elegantmonark/hardware-qrng/figures/README.md

# Figures

Figures are stored under the demonstrator whose data generated them. The current figures under `ED-1/` were produced from the preserved April 2026 dataset and must not be described as ED-2 results.

[MATLAB diagnostics](ED-1/matlab_diagnostics.png) show the same Arduino capture
analysed in MATLAB R2026b Update 1. The [saved results](../results/ED-1/matlab/README.md)
include the editable figure and numerical output.
