elegantmonark/hardware-qrng/hardware/ED-1/README.md

# ED-1 hardware

ED-1 is the original working demonstrator. It established the acquisition and analysis pipeline and produced the preserved April 2026 dataset.

Its photographs are historical evidence of that build. They must not be presented as photographs of ED-2, whose analogue path and status indicator differ.

## Photographs

### Breadboard overview

ED-1 breadboard overview

Top view of the first breadboard demonstrator, including its wired indicators and buzzer.

### Close view of the analogue stage

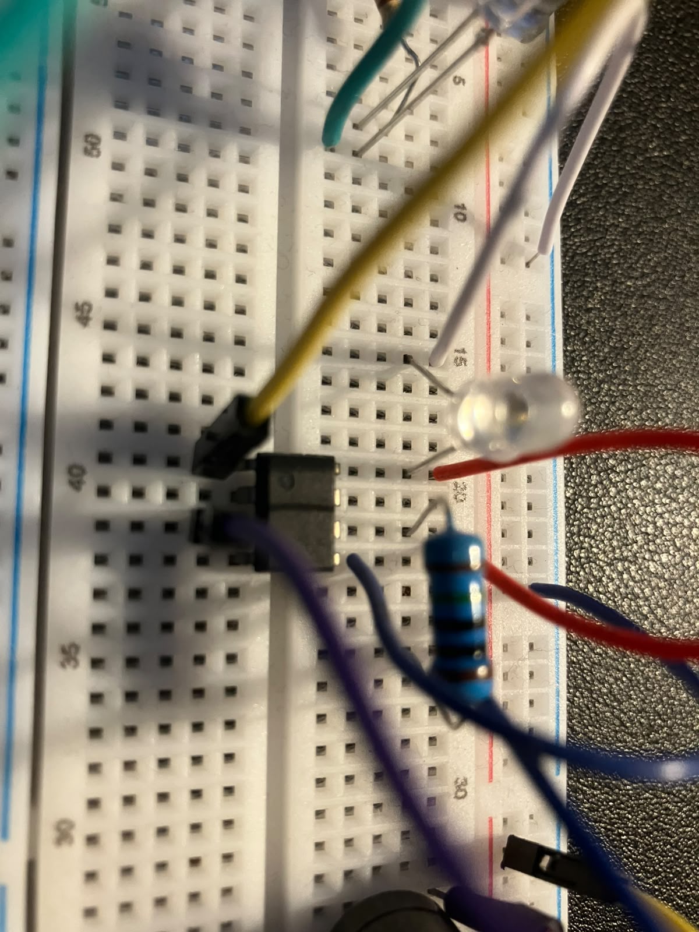
[picture p17: hardware/ED-1/photos/ed1-analogue-stage-closeup.jpeg]
ED-1 analogue-stage close-up


Close view of the original LM358 area, source LED and nearby connections.
