elegantmonark/hardware-qrng/data/ED-3/README.md

# ED-3 data

This directory is reserved for ED-3 control and source captures. No dataset
should be retained here until the staged circuit checks have passed and the
exact hardware configuration has been photographed and recorded.
