elegantmonark/hardware-qrng/hardware/ED-2/photos/README.md

# ED-2 photographs

- `ed2-breadboard-overview.jpeg`: top view of the complete ED-2 breadboard.
- `ed2-analogue-stage-closeup.jpeg`: close view of the circuit from a lower angle, with the Arduino in the background.
- `ed2-current-breadboard-closeup.jpeg`: clearest view of the latest documented ED-2 breadboard arrangement, photographed on 18 October 2026.
- `ed2-current-system-overview.jpeg`: wider view of that arrangement with the Arduino connection visible, photographed on 18 October 2026.

The source files contain no embedded location metadata. The photographs document hardware configuration only and do not establish electrical or statistical validation.
