elegantmonark/hardware-qrng/hardware/ED-3/photos/README.md

# ED-3 photographs

Add photographs only after the simplified breadboard has been assembled and its
connections have been checked. Record the date, circuit revision and whether the
pictured configuration produced a retained dataset.
