elegantmonark/hardware-qrng/hardware/ED-4/photos/README.md

# ED-4 photographs

- `ed4-printed-enclosure.jpeg`: first printed enclosure base, showing the rails, locating features and cable opening on 18 October 2026.
- `ed4-perfboard-fit-check.jpeg`: unpopulated 89 by 52 mm perfboard seated in the printed base for the initial fit check on 18 October 2026.

These images demonstrate a successful initial mechanical fit. They do not show an assembled or electrically validated ED-4 circuit.
