elegantmonark/hardware-qrng/hardware/ED-1/photos/README.md

# ED-1 photographs

- `ed1-breadboard-overview.jpeg`: top view of the complete original breadboard.
- `ed1-analogue-stage-closeup.jpeg`: close view of the LM358 and LED region.

These photographs document ED-1 and are not images of the later ED-2 circuit.
