elegantmonark/hardware-qrng/figures/ED-1/entropy_plot.png

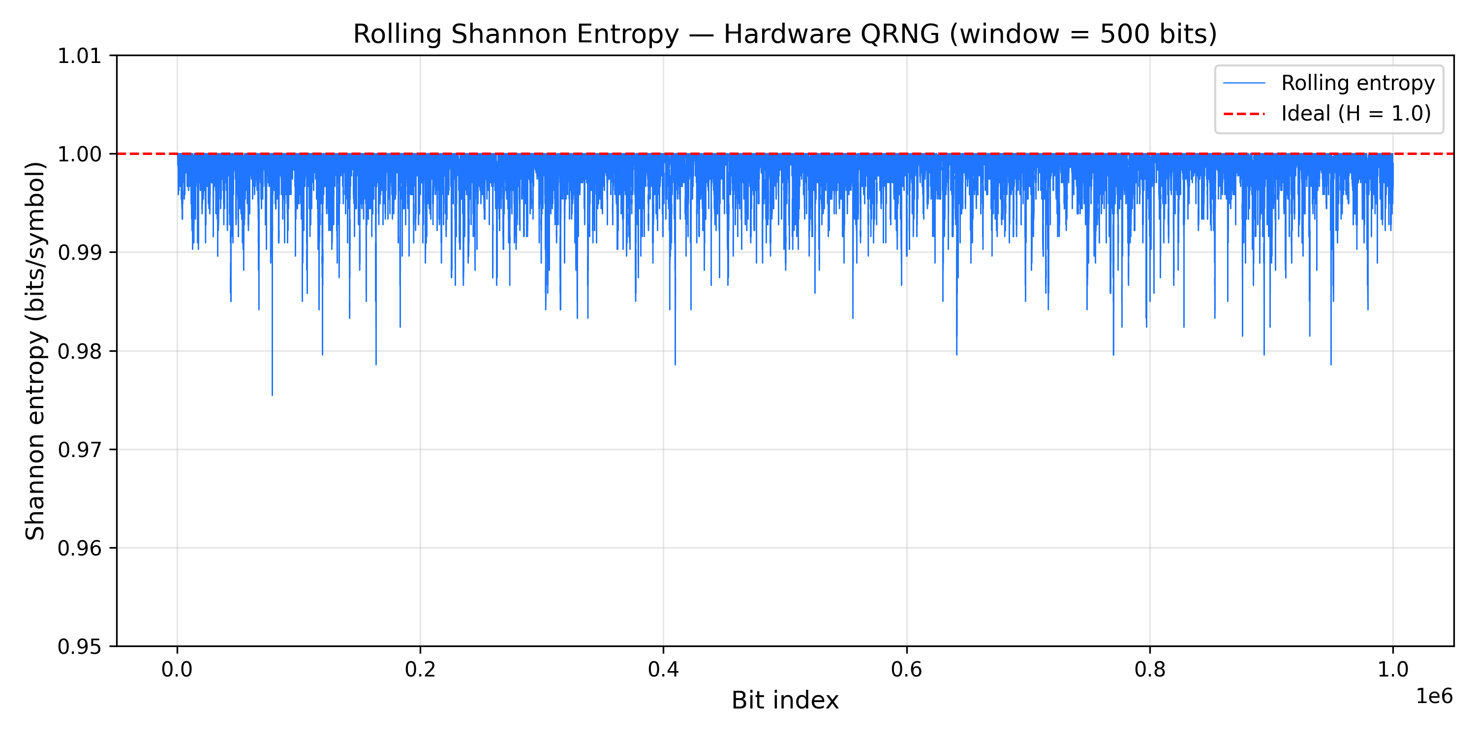
figures/ED-1/entropy_plot.png
