elegantmonark/hardware-qrng/hardware/ED-4/kicad/exports/ed4-perfboard-prototype-bottom.png

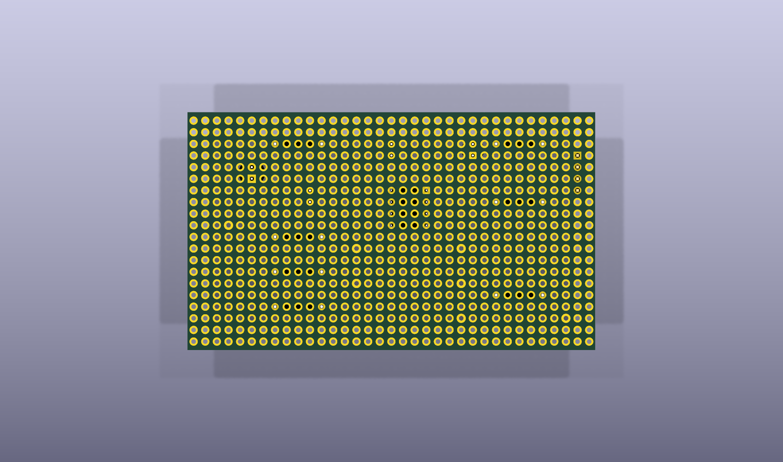
hardware/ED-4/kicad/exports/ed4-perfboard-prototype-bottom.png
