elegantmonark/hardware-qrng/hardware/ED-4/kicad/exports/ed4-perfboard-prototype-top.png

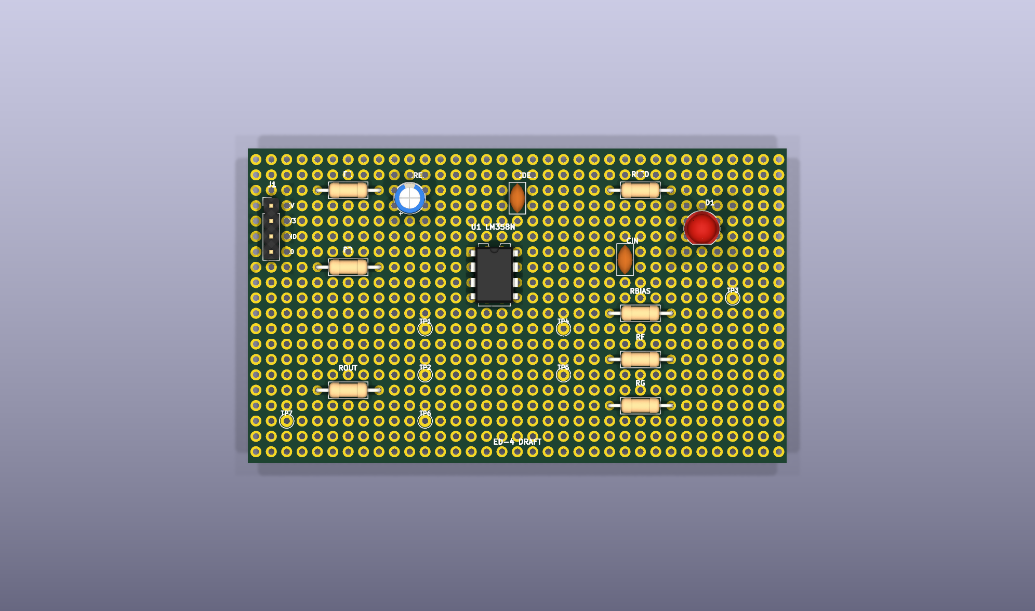
hardware/ED-4/kicad/exports/ed4-perfboard-prototype-top.png
