elegantmonark/hardware-qrng/hardware/ED-4/pcb/ED4-A/jlcpcb/ED4_A_RevB_JLCPCB_BOM.csv

Comment | Designator | Footprint | JLCPCB Part # | Manufacturer Part Number
ARDUINO | J1 | PinHeader_1x04_P2.54mm_Vertical | C7221145 | M20-9990446
MCP6002-I/P | U1 | DIP-8_W7.62mm | C640394 | MCP6002-I/P
10k | R1 | R_Axial_DIN0207_L6.3mm_D2.5mm_P10.16mm_Horizontal | C1519255 | MFR-25FBF52-10K
10k | R2 | R_Axial_DIN0207_L6.3mm_D2.5mm_P10.16mm_Horizontal | C1519255 | MFR-25FBF52-10K
10uF | C1 | CP_Radial_D5.0mm_P2.00mm | C106654 | ERS1HM100D11OT
100nF | C2 | C_Disc_D5.0mm_W2.5mm_P2.50mm | C524651 | RDER71H104K0S1H03A
10uF | C3 | CP_Radial_D5.0mm_P2.00mm | C106654 | ERS1HM100D11OT
SOURCE OR CONTROL | JP1 | PinHeader_1x03_P2.54mm_Vertical | C5355646 | M20-9990346
100nF | C4 | C_Rect_L7.2mm_W2.5mm_P5.00mm | C97687 | MKS2C031001A00KSSD
1k | R5 | R_Axial_DIN0207_L6.3mm_D2.5mm_P10.16mm_Horizontal | C1364484 | MFR-25FBF52-1K
1k | R7 | R_Axial_DIN0207_L6.3mm_D2.5mm_P10.16mm_Horizontal | C1364484 | MFR-25FBF52-1K
