elegantmonark/hardware-qrng/hardware/ED-3/cad/ed3_base.stl

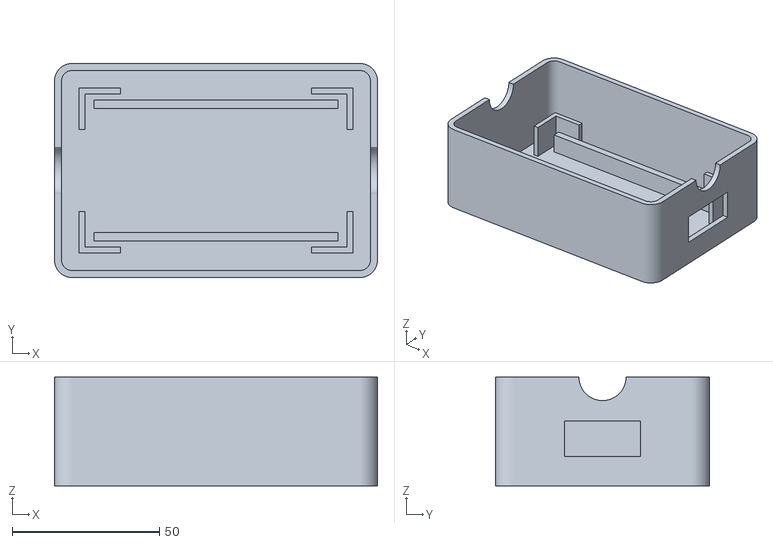
[picture p27: CAD file, 2026-10-16]
hardware/ED-3/cad/ed3_base.stl
109.8 x 72.8 x 37.0
