elegantmonark/hardware-qrng/hardware/ED-4/cad/ed4_lid.stl

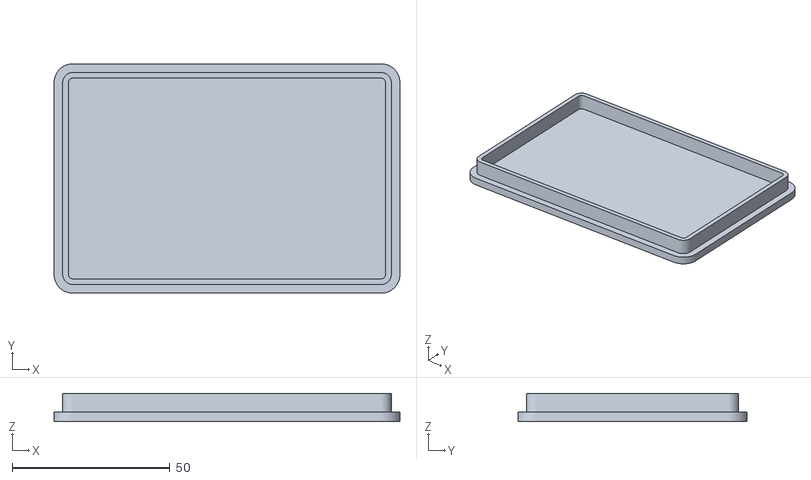
[picture p28: CAD file, 2026-10-17]
hardware/ED-4/cad/ed4_lid.stl
109.8 x 72.8 x 9.00
