elegantmonark/hardware-qrng/(list of files, cad)

Other CAD files:
hardware/ED-4/cad/ed4_enclosure.scad
