elegantmonark/hardware-qrng/results/README.md

# Results

Results are separated by demonstrator and dataset. `ED-1/` contains the April 2026 audit and exploratory NIST STS outputs. No ED-2 statistical result should be added without its source dataset, metadata, and exact analysis command.

[MATLAB results](ED-1/matlab/README.md) contain the exported report, summary,
correlations and editable figure from analysis of the original Arduino capture.
