elegantmonark/hardware-qrng/results/ED-1/nist/README.md

# ED-1 exploratory NIST STS results

These files record exploratory testing of the preserved April 2026 ED-1 bitstream. They are retained for transparency and are not evidence of certification or cryptographic suitability.
