elegantmonark/hardware-qrng/results/ED-1/matlab/autocorrelation.csv

lags | rawAcf | bitAcf
0 | 1 | 1
1 | 0.905703941458342 | 0.00119307981327386
2 | 0.648338970932204 | -0.000847972736750477
3 | 0.281083008862342 | -0.00116897203801129
4 | -0.127963543272865 | 5.00648950270875e-05
5 | -0.505038471001941 | 0.00186511913377597
6 | -0.785984445532592 | -0.000523949937571101
7 | -0.930931903308537 | 0.00107309255088027
8 | -0.920346089999902 | -0.00012394877930944
9 | -0.755725271255222 | 0.000183051030901383
10 | -0.459099145915034 | -0.000159959077419183
11 | -0.0736146732049842 | -0.00220903159773946
12 | 0.334114395782394 | 0.000462060433140151
13 | 0.690365283552068 | -0.000268963208252143
14 | 0.92862595560735 | 0.000992079308777697
15 | 0.998006396714877 | 0.00170510519747965
16 | 0.879731687416893 | 0.00202211827758914
17 | 0.604249335466105 | -0.00101898314121326
18 | 0.227248370902159 | 0.000938090080624857
19 | -0.181759074843972 | -4.94572756822201e-06
20 | -0.549227526489565 | 0.00105209647083485
21 | -0.813786206689639 | -0.000446963875666681
22 | -0.938701149457202 | -0.00118800435730024
23 | -0.906963148330584 | -0.00011495948363881
24 | -0.72306228483475 | 0.000122050796799136
25 | -0.41151233671605 | -0.000674975991193557
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
