elegantmonark/hardware-qrng/hardware/ED-4/kicad/exports/ed4-perfboard-prototype-schematic.pdf

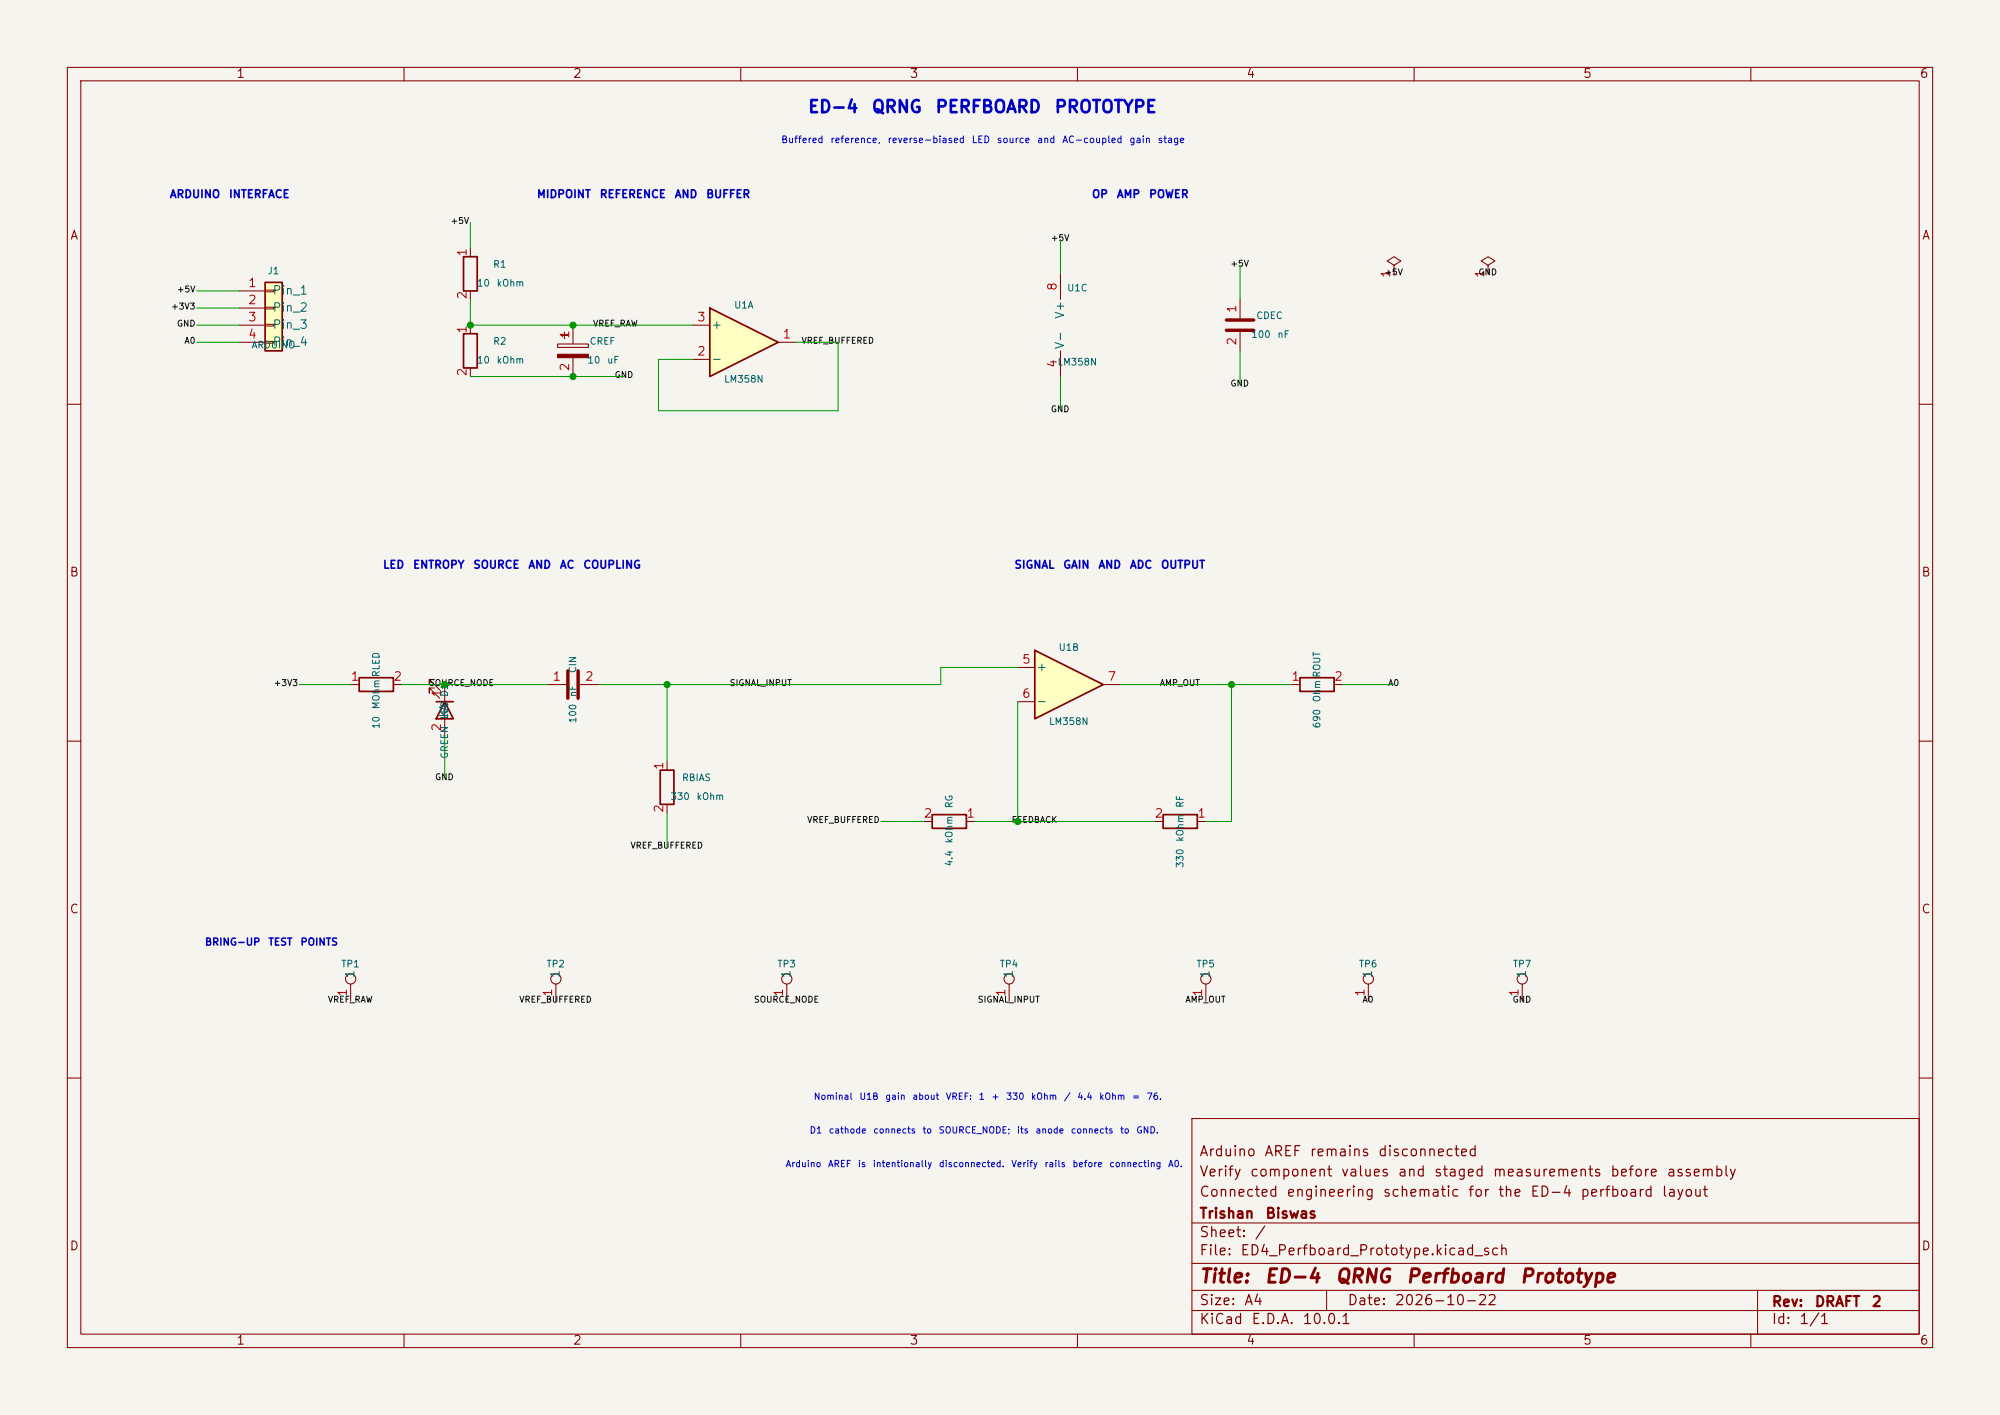
[picture p29: page 1]

Buffered reference, reverse-biased LED source and AC-coupled gain stage SIGNAL GAIN AND ADC OUTPUT MIDPOINT REFERENCE AND BUFFER

BRING-UP TEST POINTS

Nominal U1B gain about VREF: 1 + 330 kOhm / 4.4 kOhm = 76.

Arduino AREF is intentionally disconnected. Verify rails before connecting A0. D1 cathode connects to SOURCE_NODE; its anode connects to GND.

Arduino AREF remains disconnected
Verify component values and staged measurements before assembly
Connected engineering schematic for the ED-4 perfboard layout
Trishan Biswas
Sheet: /
File: ED4_Perfboard_Prototype.kicad_sch
Title: ED-4 QRNG Perfboard Prototype

Size: A4 | Rev: DRAFT 2
KiCad E.D.A. 10.0.1 | Id: 1/1
