elegantmonark/hardware-qrng/hardware/ED-4/pcb/ED4-A/drawings/ED4_A_assembly.pdf

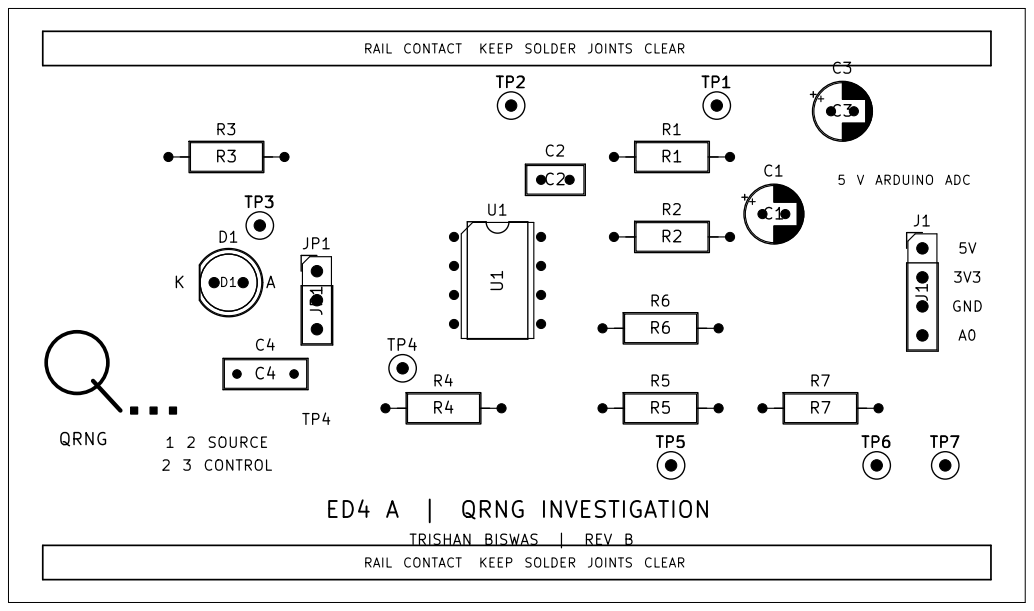
[picture p30: page 1]

RAIL CONTACT KEEP SOLDER JOINTS CLEAR

5 V ARDUINO ADC 1 2 SOURCE 2 3 CONTROL
