elegantmonark/hardware-qrng/hardware/ED-4/pcb/ED4-A/drawings/ED4_A_schematic.pdf

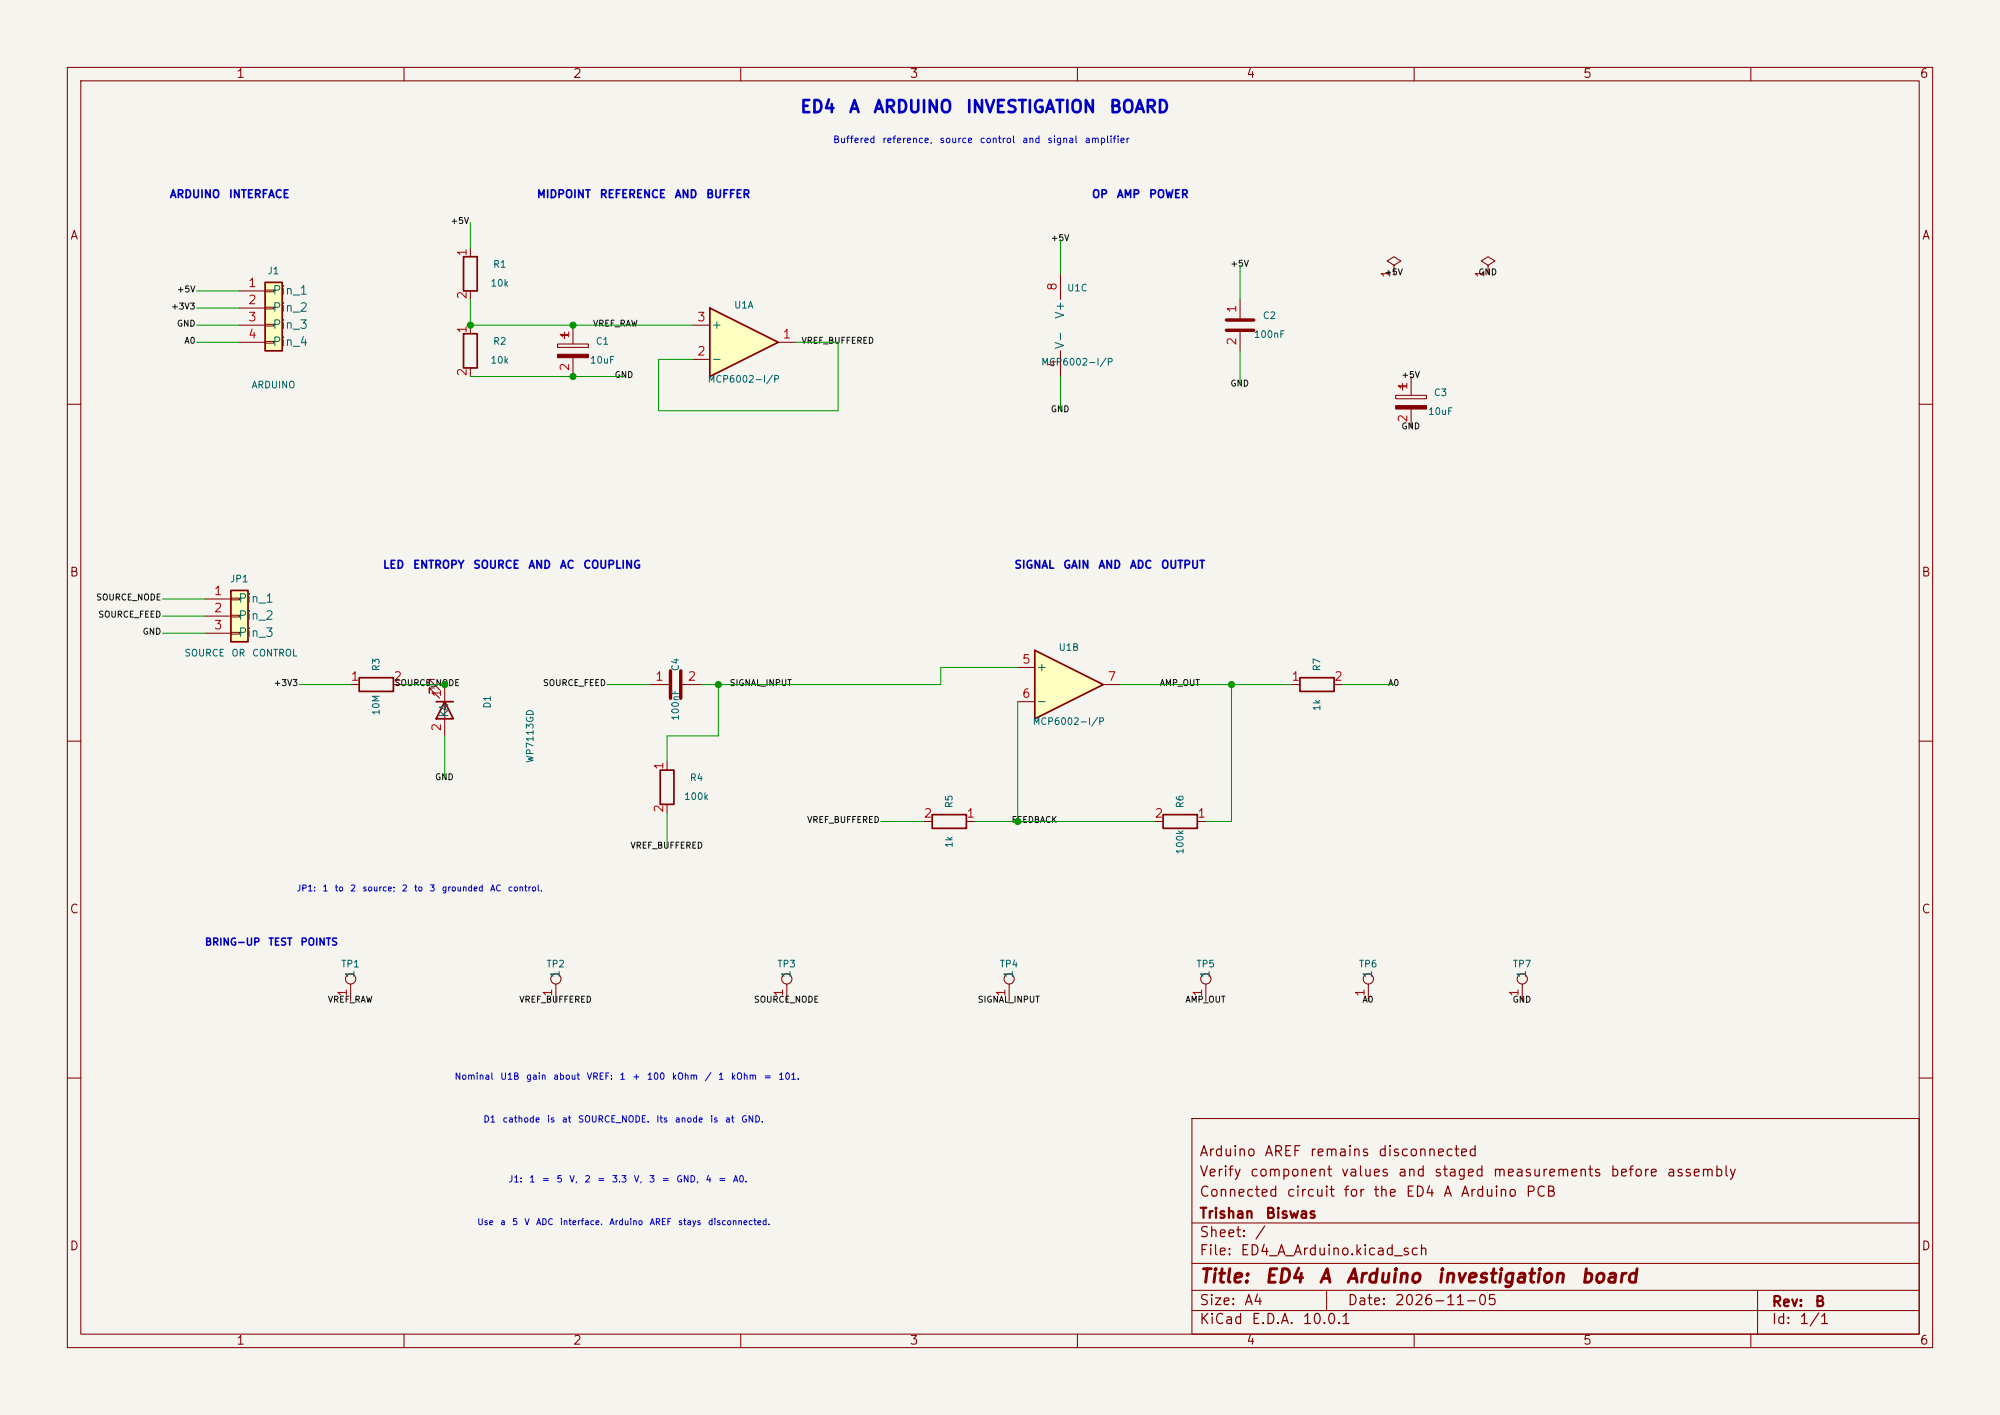
[picture p31: page 1]

LED ENTROPY SOURCE AND AC COUPLING

Nominal U1B gain about VREF: 1 + 100 kOhm / 1 kOhm = 101. D1 cathode is at SOURCE_NODE. Its anode is at GND. J1: 1 = 5 V, 2 = 3.3 V, 3 = GND, 4 = A0. Use a 5 V ADC interface. Arduino AREF stays disconnected.

Arduino AREF remains disconnected
Verify component values and staged measurements before assembly
Connected circuit for the ED4 A Arduino PCB
Trishan Biswas
Sheet: /
File: ED4_A_Arduino.kicad_sch
Title: ED4 A Arduino investigation board

Size: A4 | Rev: B
KiCad E.D.A. 10.0.1 | Id: 1/1
