elegantmonark/hardware-qrng/hardware/ED-4/pcb/ED4-A/ED4_A_Arduino.kicad_pcb

## KiCad design hardware/ED-4/pcb/ED4-A/ED4_A_Arduino.kicad_pcb (2026-11-05)

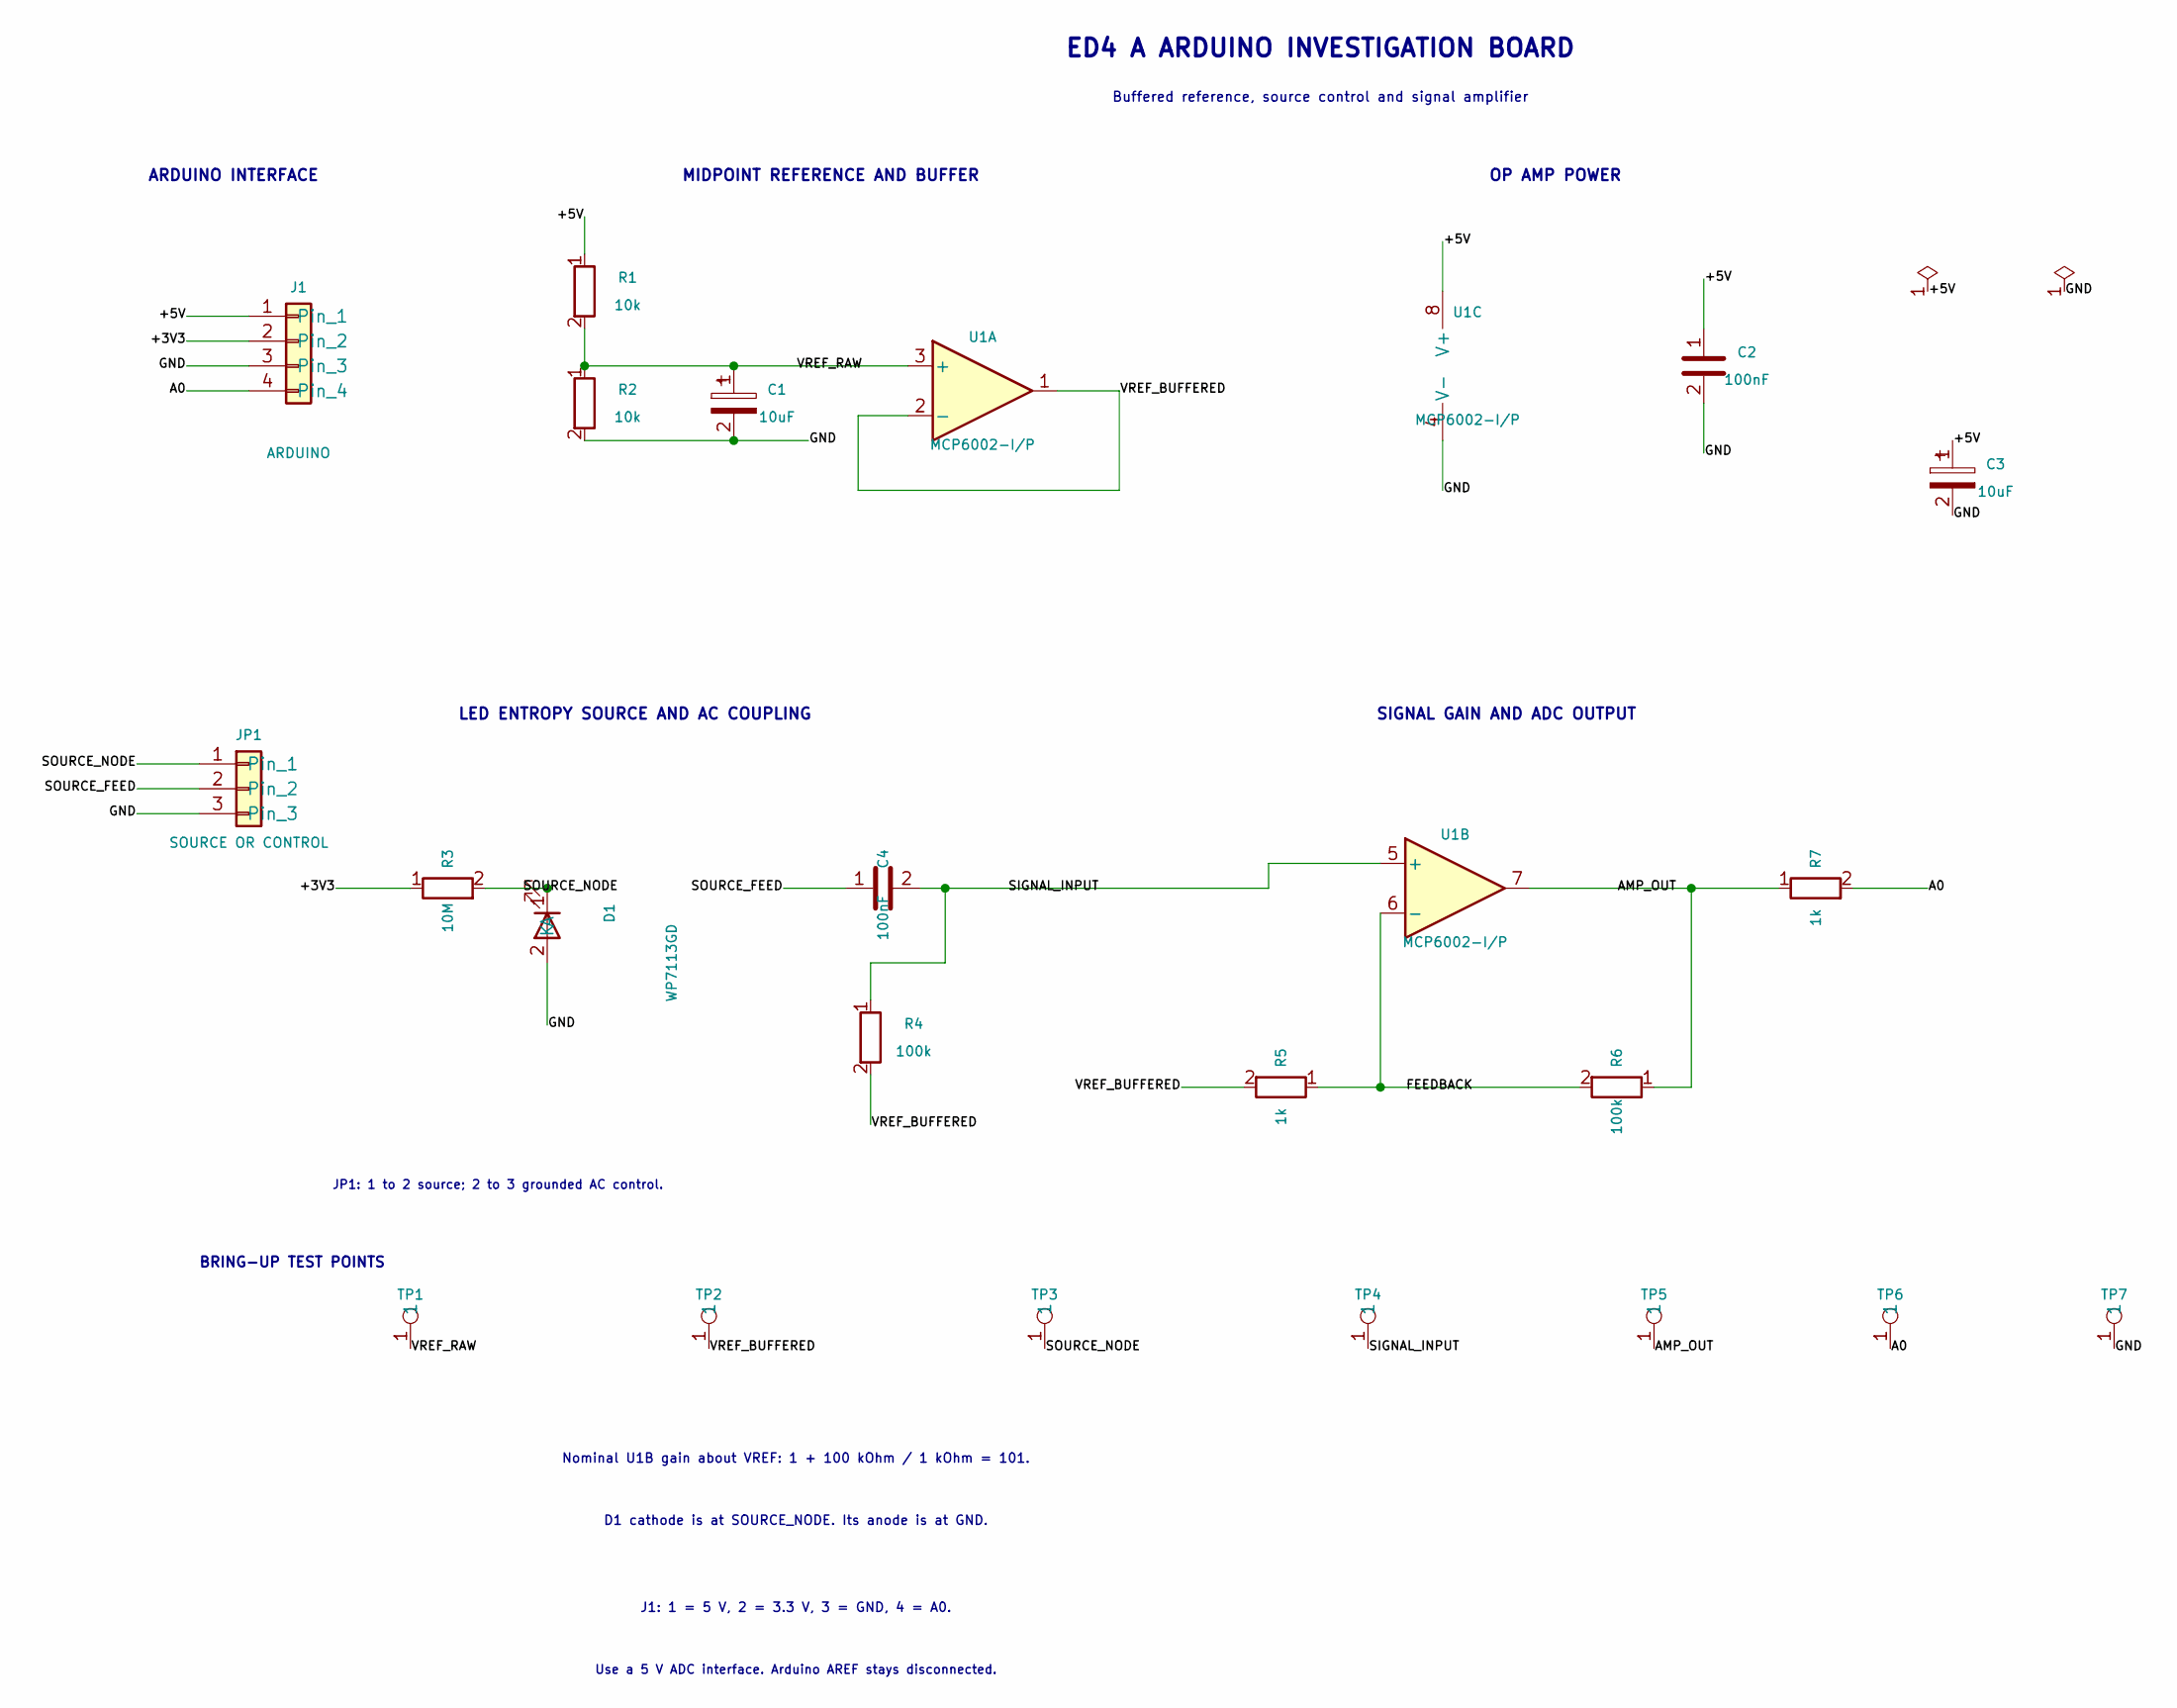
[picture p32: schematic ED4_A_Arduino.kicad_sch, ED4 A Arduino investigation board]

Parts:
C1, C3: 10uF; CP_Radial_D5.0mm_P2.00mm
C2: 100nF; C_Disc_D5.0mm_W2.5mm_P2.50mm
C4: 100nF; C_Rect_L7.2mm_W2.5mm_P5.00mm
D1: WP7113GD; LED_D5.0mm
J1: ARDUINO; PinHeader_1x04_P2.54mm_Vertical
JP1: SOURCE OR CONTROL; PinHeader_1x03_P2.54mm_Vertical
R1, R2: 10k; R_Axial_DIN0207_L6.3mm_D2.5mm_P10.16mm_Horizontal
R3: 10M; R_Axial_DIN0207_L6.3mm_D2.5mm_P10.16mm_Horizontal
R4, R6: 100k; R_Axial_DIN0207_L6.3mm_D2.5mm_P10.16mm_Horizontal
R5, R7: 1k; R_Axial_DIN0207_L6.3mm_D2.5mm_P10.16mm_Horizontal
TP1: VREF_RAW; TestPoint_THTPad_D2.0mm_Drill1.0mm
TP2: VREF_BUFFERED; TestPoint_THTPad_D2.0mm_Drill1.0mm
TP3: SOURCE_NODE; TestPoint_THTPad_D2.0mm_Drill1.0mm
TP4: SIGNAL_INPUT; TestPoint_THTPad_D2.0mm_Drill1.0mm
TP5: AMP_OUT; TestPoint_THTPad_D2.0mm_Drill1.0mm
TP6: A0; TestPoint_THTPad_D2.0mm_Drill1.0mm
TP7: GND; TestPoint_THTPad_D2.0mm_Drill1.0mm
U1: MCP6002-I/P; DIP-8_W7.62mm

Connections:
/+3V3: J1.2, R3.1
/+5V: C2.1, C3.1, J1.1, R1.1, U1.8 (V+)
/A0: J1.4, R7.2, TP6.1
/AMP_OUT: R6.1, R7.1, TP5.1, U1.7
/FEEDBACK: R5.1, R6.2, U1.6 (-)
/GND: C1.2, C2.2, C3.2, D1.2 (A), J1.3, JP1.3, R2.2, TP7.1, U1.4 (V-)
/SIGNAL_INPUT: C4.2, R4.1, TP4.1, U1.5 (+)
/SOURCE_FEED: C4.1, JP1.2
/SOURCE_NODE: D1.1 (K), JP1.1, R3.2, TP3.1
/VREF_BUFFERED: R4.2, R5.2, TP2.1, U1.1, U1.2 (-)
/VREF_RAW: C1.1, R1.2, R2.1, TP1.1, U1.3 (+)

Notes on the sheet:
ED4 A ARDUINO INVESTIGATION BOARD
Buffered reference, source control and signal amplifier
ARDUINO INTERFACE
MIDPOINT REFERENCE AND BUFFER
OP AMP POWER
LED ENTROPY SOURCE AND AC COUPLING
JP1: 1 to 2 source; 2 to 3 grounded AC control.
SIGNAL GAIN AND ADC OUTPUT
BRING-UP TEST POINTS
Nominal U1B gain about VREF: 1 + 100 kOhm / 1 kOhm = 101.
D1 cathode is at SOURCE_NODE. Its anode is at GND.
J1: 1 = 5 V, 2 = 3.3 V, 3 = GND, 4 = A0.
Use a 5 V ADC interface. Arduino AREF stays disconnected.

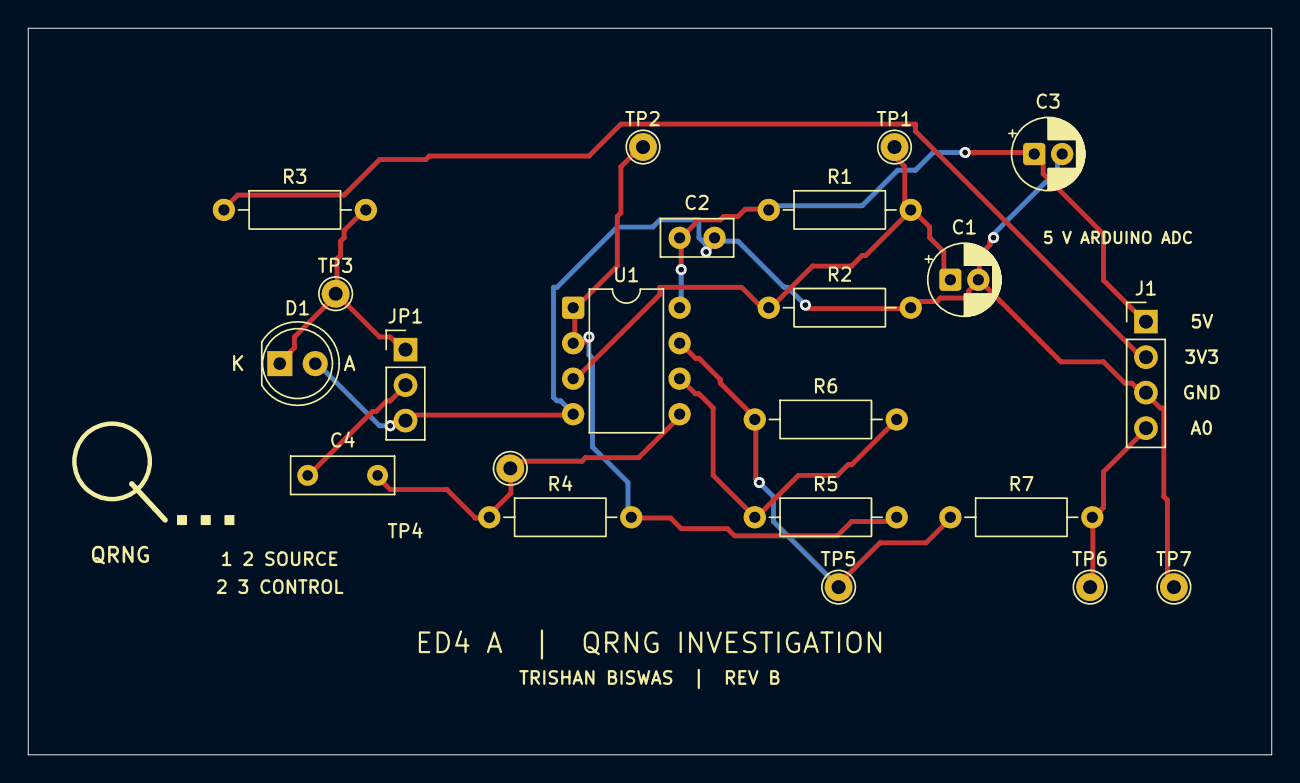
[picture p33: board ED4_A_Arduino.kicad_pcb from above]

Board: 2 copper layers, 89.0 x 52.0 mm, 22 parts (0 on the bottom side), 11 nets.
