elegantmonark/hardware-qrng/hardware/ED-4/kicad/ED4_Perfboard_Prototype.kicad_pcb

## KiCad design hardware/ED-4/kicad/ED4_Perfboard_Prototype.kicad_pcb (2026-10-22)

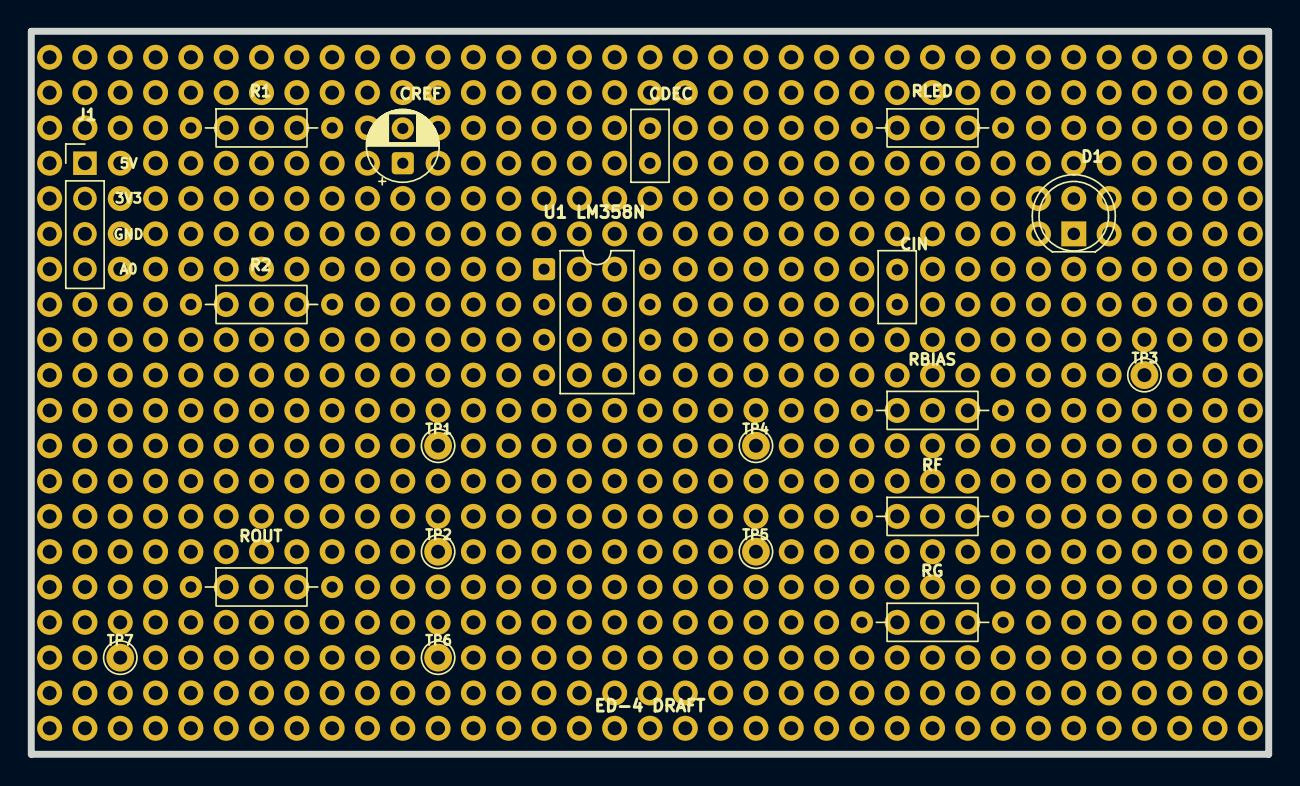
[picture p34: board ED4_Perfboard_Prototype.kicad_pcb from above]

Board: 2 copper layers, 89.0 x 52.0 mm, 21 parts (0 on the bottom side), 10 nets, no tracks yet.

Parts:
CDEC: 100 nF; C_Disc_D5.0mm_W2.5mm_P2.50mm
CIN: 100 nF; C_Disc_D5.0mm_W2.5mm_P2.50mm
CREF: 10 uF; CP_Radial_D5.0mm_P2.50mm
D1: GREEN SOURCE LED; LED_D5.0mm
GRID1: 89x52 mm perfboard, 2.54 mm pitch
J1: ARDUINO; PinHeader_1x04_P2.54mm_Vertical
R1, R2: 10 kOhm; R_Axial_DIN0207_L6.3mm_D2.5mm_P10.16mm_Horizontal
RBIAS: 330 kOhm; R_Axial_DIN0207_L6.3mm_D2.5mm_P10.16mm_Horizontal
RF: 330 kOhm; R_Axial_DIN0207_L6.3mm_D2.5mm_P10.16mm_Horizontal
RG: 4.4 kOhm; R_Axial_DIN0207_L6.3mm_D2.5mm_P10.16mm_Horizontal
RLED: 10 MOhm; R_Axial_DIN0207_L6.3mm_D2.5mm_P10.16mm_Horizontal
ROUT: 690 Ohm; R_Axial_DIN0207_L6.3mm_D2.5mm_P10.16mm_Horizontal
TP1: VREF RAW; TestPoint_THTPad_D2.0mm_Drill1.0mm
TP2: VREF BUFFERED; TestPoint_THTPad_D2.0mm_Drill1.0mm
TP3: SOURCE; TestPoint_THTPad_D2.0mm_Drill1.0mm
TP4: SIGNAL INPUT; TestPoint_THTPad_D2.0mm_Drill1.0mm
TP5: AMP OUTPUT; TestPoint_THTPad_D2.0mm_Drill1.0mm
TP6: A0; TestPoint_THTPad_D2.0mm_Drill1.0mm
TP7: GND; TestPoint_THTPad_D2.0mm_Drill1.0mm
U1: LM358N; DIP-8_W7.62mm

Connections:
+3V3: J1.2, RLED.1
+5V: CDEC.1, J1.1, R1.1, U1.8
A0: J1.4, ROUT.2, TP6.1
AMP_OUT: RF.1, ROUT.1, TP5.1, U1.7
FEEDBACK: RF.2, RG.1, U1.6
GND: CDEC.2, CREF.2, D1.2, J1.3, R2.2, TP7.1, U1.4
SIGNAL_INPUT: CIN.2, RBIAS.1, TP4.1, U1.5
SOURCE_NODE: CIN.1, D1.1, RLED.2, TP3.1
VREF_BUFFERED: RBIAS.2, RG.2, TP2.1, U1.1, U1.2
VREF_RAW: CREF.1, R1.2, R2.1, TP1.1, U1.3
