elegantmonark/hardware-qrng/(commit log)

2026-10-16 Reduce ED 3 enclosure height
2026-10-17 Add PlatformIO workflow for ED-2 sampler
2026-10-17 Document ED-3 redesign and ED-4 enclosure prototype
2026-10-22 Add ED-4 KiCad schematic and perfboard render
2026-11-05 Add ED4 A Arduino PCB revision B
2026-11-05 Add ED4 A JLCPCB assembly files
2026-11-05 Add ED4-A PCB views and ngspice checks
